bbi1234567890/RP2040-Keyboard/KiCad/keyboardnew.kicad_sch

## KiCad design KiCad/keyboardnew.kicad_sch (2026-07-10)

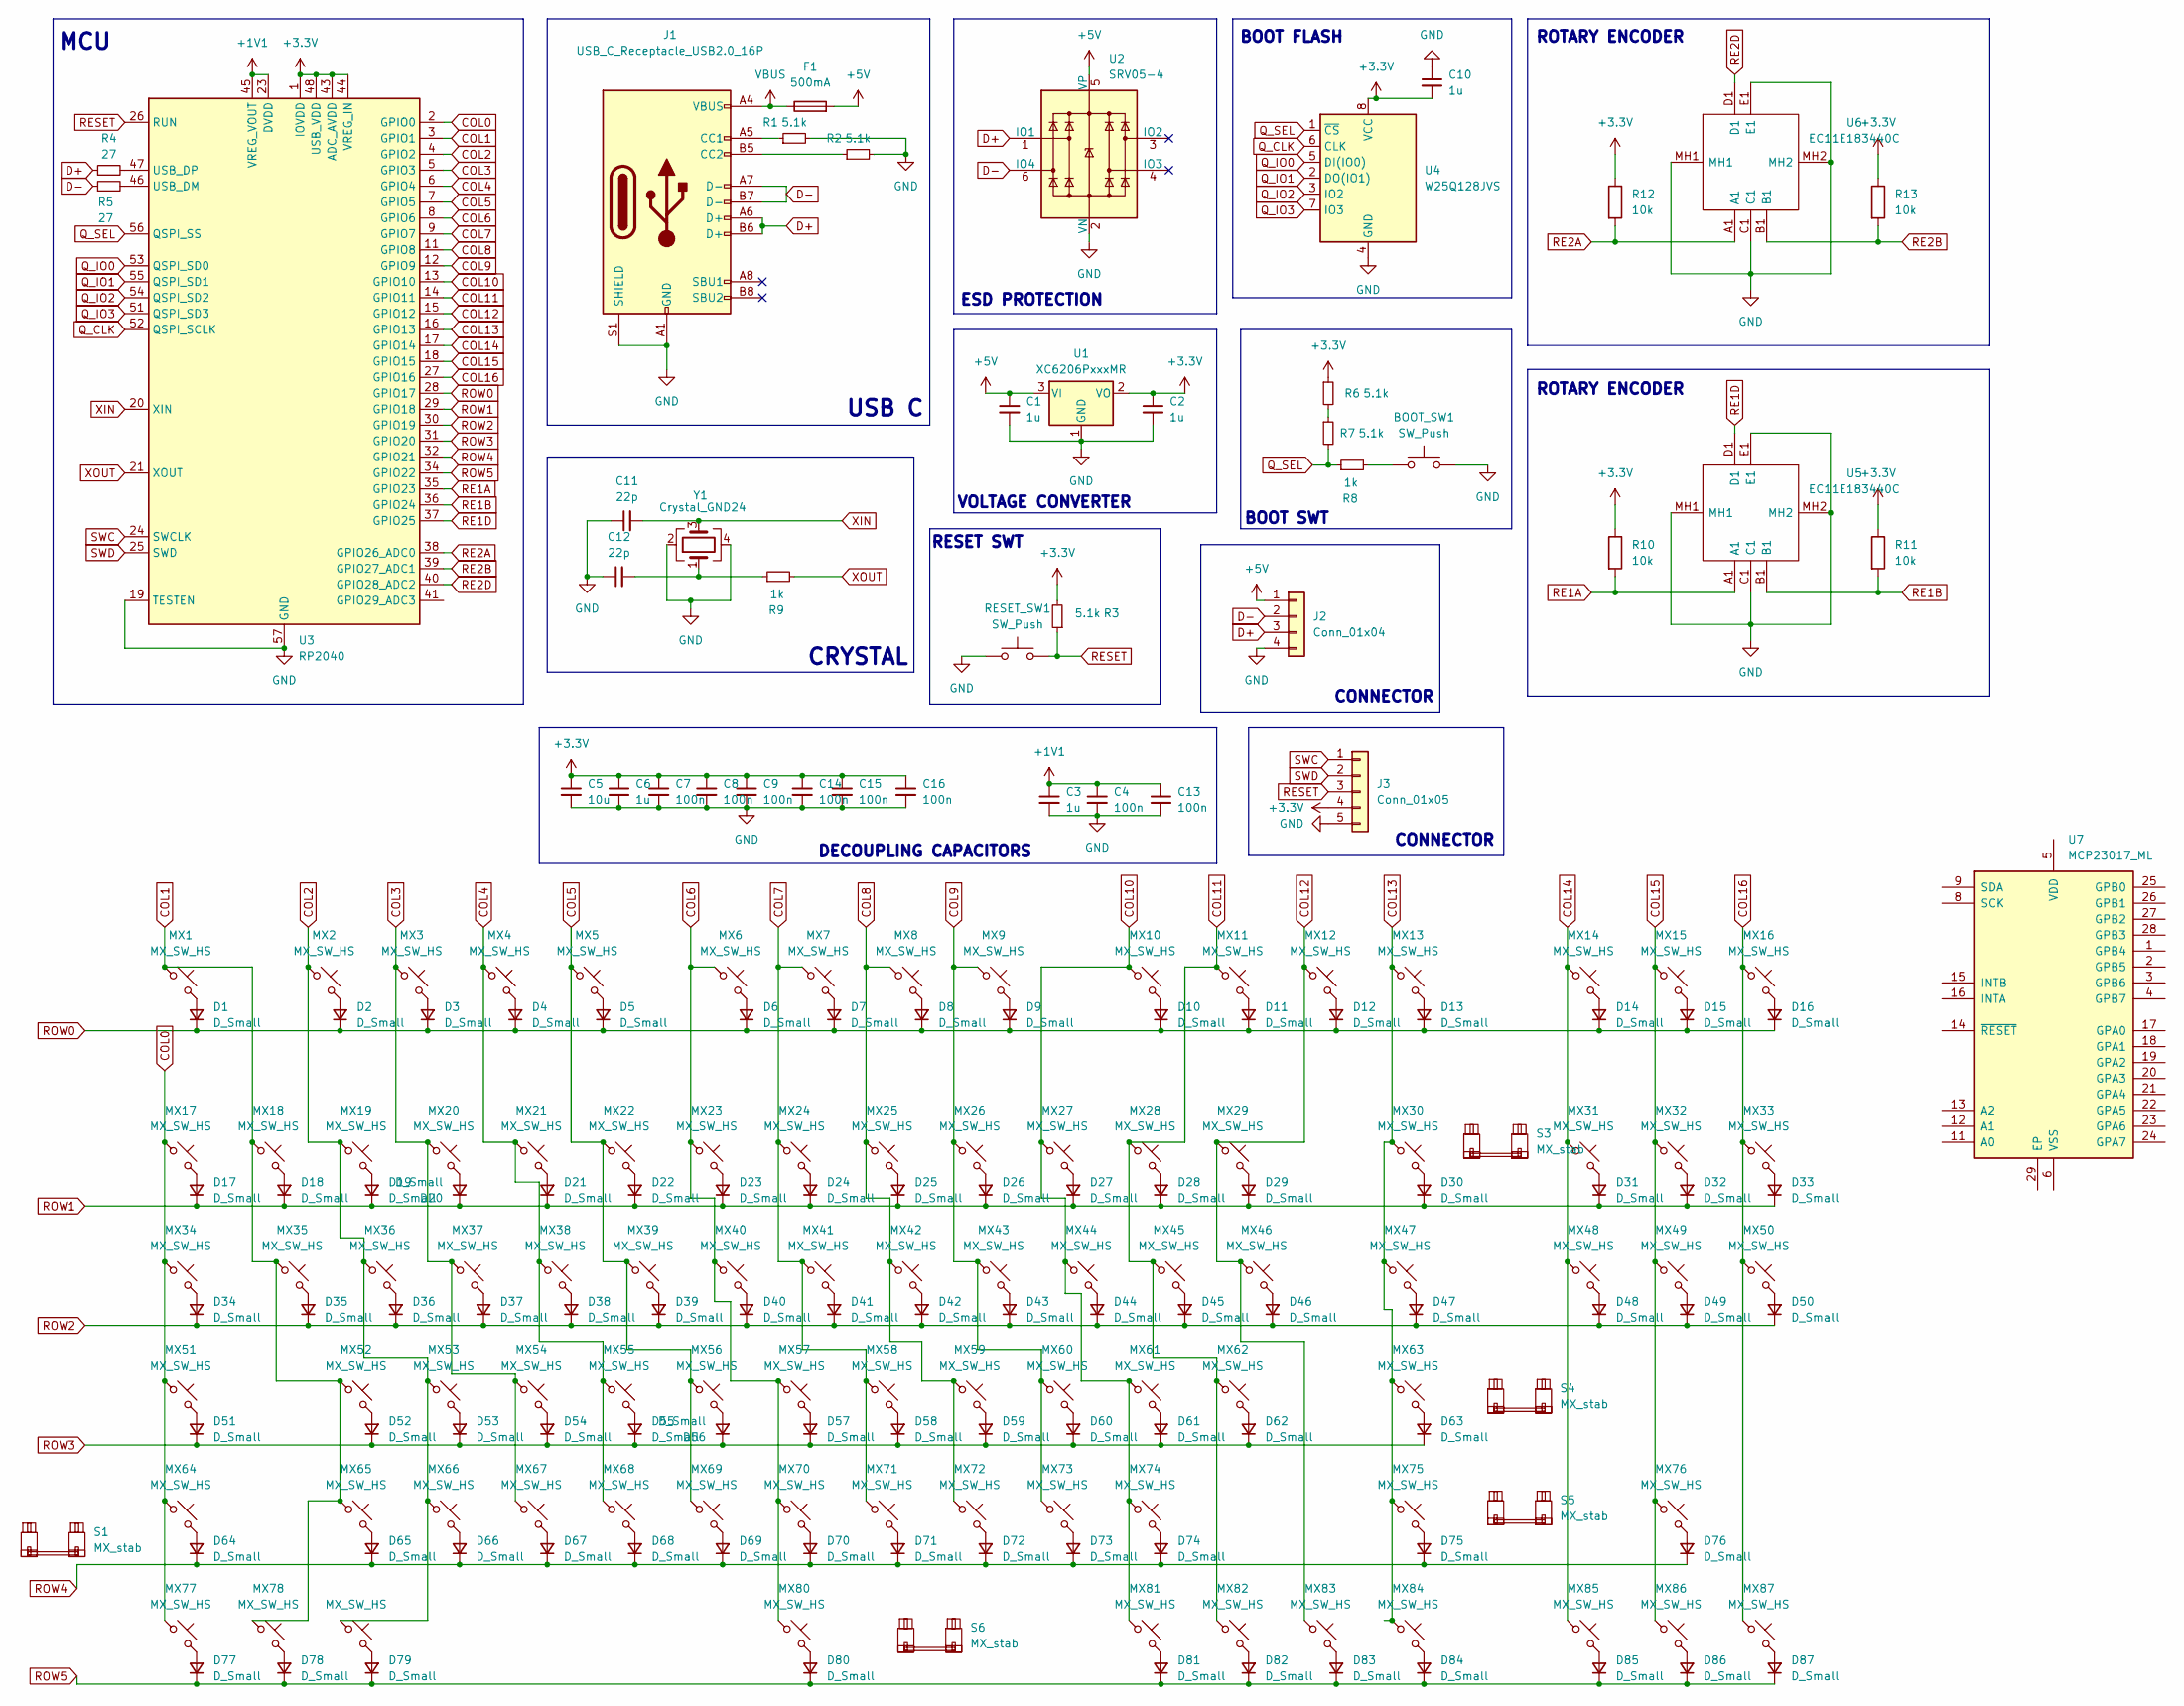
[picture p1: schematic keyboardnew.kicad_sch]

Parts:
BOOT_SW1: SW_Push; SW_SPST_TL3342; Part Number TL3342F160QG
C1, C2, C3, C6, C10: 1u; C_0402_1005Metric; Part Number TMK105BJ105MV-F
C4, C7, C8, C9, C13, C14, C15, C16: 100n; C_0402_1005Metric; Part Number LMK105BJ104KV-F
C5: 10u; C_0603_1608Metric; Part Number AMK105CBJ106MVHF
C11, C12: 22p; C_0402_1005Metric; Part Number 04023A220FAT2A
D1, D2, D3, D4, D5, D6, D7, D8, D9, D10, D11, D12, D13, D14, D15, D16, D17, D18, D19, D20, D21, D22, D23, D24, D25, D26, D27, D28, D29, D30, D31, D32, D33, D34, D35, D36, D37, D38, D39, D40, D41, D42, D43, D44, D45, D46, D47, D48, D49, D50, D51, D52, D53, D54, D55, D56, D57, D58, D59, D60, D61, D62, D63, D64, D65, D66, D67, D68, D69, D70, D71, D72, D73, D74, D75, D76, D77, D78, D79, D80, D81, D82, D83, D84, D85, D86, D87: D_Small; D_SOD-123; Part Number MMSD4148
F1: 500mA; Fuse_1206_3216Metric; Part Number SF-1206FP050-2
J1: USB_C_Receptacle_USB2.0_16P; USB_C_Receptacle_HRO_TYPE-C-31-M-12; Part Number TYPE-C-31-M-12
J2: Conn_01x04; JST_SH_SM04B-SRSS-TB_1x04-1MP_P1.00mm_Horizontal; Part Number SM04B-SRSS-TB
J3: Conn_01x05; PinHeader_1x05_P2.54mm_Vertical; Part Number PH1-05-UA
MX1, MX2, MX3, MX4, MX5, MX6, MX7, MX8, MX9, MX10, MX11, MX12, MX13, MX14, MX15, MX16, MX17, MX18, MX19, MX20, MX21, MX22, MX23, MX24, MX25, MX26, MX27, MX28, MX29, MX30, MX31, MX32, MX33, MX35, MX36, MX37, MX38, MX39, MX40, MX41, MX42, MX43, MX44, MX45, MX46, MX48, MX49, MX50, MX52, MX53, MX54, MX55, MX56, MX57, MX58, MX59, MX60, MX61, MX62, MX63, MX64, MX65, MX66, MX67, MX68, MX69, MX70, MX71, MX72, MX73, MX74, MX75, MX76, MX80, MX85, MX86, MX87: MX_SW_HS; SW_MX_HS_CPG151101S11_1u; Part Number CPG151101S11-16
MX34, MX47: MX_SW_HS; SW_MX_HS_KS-2P02B01-01_1.5u; Part Number CPG151101S11-16
MX51: MX_SW_HS; SW_MX_HS_KS-2P02B01-01_1.75u; Part Number CPG151101S11-16
MX77, MX78, MX79, MX81, MX82, MX83, MX84: MX_SW_HS; SW_MX_HS_KS-2P02B01-01_1.25u; Part Number CPG151101S11-16
R1, R2, R3, R6, R7: 5.1k; R_0402_1005Metric; Part Number ERJ-2RKF5101X
R4, R5: 27; R_0402_1005Metric; Part Number ERJ-2RKF27R0X
R8, R9: 1k; R_0402_1005Metric; Part Number ERJ-2RKF1001X
R10, R11, R12, R13: 10k; R_0402_1005Metric; Part Number ERJ-2RKF1002X
RESET_SW1: SW_Push; SW_SPST_TL3342; Part Number TL3342F160QG
S1, S4: MX_stab; STAB_MX_P_2.25u
S3: MX_stab; STAB_MX_P_2u
S5: MX_stab; STAB_MX_P_2.75u
S6: MX_stab; STAB_MX_P_6.25u
U1: XC6206PxxxMR; SOT-23-3; Part Number XC6206P502MR
U2: SRV05-4; SOT-23-6-routable; Part Number SRV05-4MR6T1G
U3: RP2040; QFN-56-1EP_7x7mm_P0.4mm_EP3.2x3.2mm; Part Number RP2040
U4: W25Q128JVS; SOIC-8_5.23x5.23mm_P1.27mm; Part Number W25Q128JVSIM
U5, U6: EC11E183440C; Manufacturer_Part_Number EC11E183440C; Mouser Part Number 688-EC11E183440C
U7: MCP23017_ML; QFN-28-1EP_6x6mm_P0.65mm_EP4.25x4.25mm
Y1: Crystal_GND24; Crystal_SMD_3225-4Pin_3.2x2.5mm; Part Number ABM8-272-T3

Connections:
+1V1: C3.1, C4.1, C13.1, U3.23 (DVDD), U3.45 (VREG_VOUT), U3.50 (DVDD)
+3.3V: C2.1, C5.1, C6.1, C7.1, C8.1, C9.1, C10.2, C14.1, C15.1, C16.1, J3.4, R3.2, R6.1, R10.1, R11.1, R12.1, R13.1, U1.2 (VO), U3.1 (IOVDD), U3.10 (IOVDD), U3.22 (IOVDD), U3.33 (IOVDD), U3.42 (IOVDD), U3.43 (ADC_AVDD), U3.44 (VREG_IN), U3.48 (USB_VDD), U3.49 (IOVDD), U4.8 (VCC)
+5V: C1.1, F1.2, J2.1, U1.3 (VI), U2.5 (VP)
COL0: MX17.1, MX34.1, MX51.1, MX64.1, MX77.1, U3.2 (GPIO0)
COL1: MX1.1, MX18.1, MX35.1, MX52.1, MX65.1, MX78.1, U3.3 (GPIO1)
COL2: MX2.1, MX19.1, MX36.1, MX53.1, MX66.1, MX79.1, U3.4 (GPIO2)
COL3: MX3.1, MX20.1, MX37.1, MX54.1, MX67.1, U3.5 (GPIO3)
COL4: MX4.1, MX21.1, MX38.1, MX55.1, MX68.1, U3.6 (GPIO4)
COL5: MX5.1, MX22.1, MX39.1, MX56.1, MX69.1, U3.7 (GPIO5)
COL6: MX6.1, MX23.1, MX40.1, MX57.1, MX70.1, MX80.1, U3.8 (GPIO6)
COL7: MX7.1, MX24.1, MX41.1, MX58.1, MX71.1, U3.9 (GPIO7)
COL8: MX8.1, MX25.1, MX42.1, MX59.1, MX72.1, U3.11 (GPIO8)
COL9: MX9.1, MX26.1, MX43.1, MX60.1, MX73.1, U3.12 (GPIO9)
COL10: MX10.1, MX27.1, MX44.1, MX61.1, MX74.1, MX81.1, U3.13 (GPIO10)
COL11: MX11.1, MX28.1, MX45.1, MX62.1, MX82.1, U3.14 (GPIO11)
COL12: MX12.1, MX29.1, MX46.1, MX83.1, U3.15 (GPIO12)
COL13: MX13.1, MX30.1, MX47.1, MX63.1, MX75.1, MX84.1, U3.16 (GPIO13)
COL14: MX14.1, MX31.1, MX48.1, MX85.1, U3.17 (GPIO14)
COL15: MX15.1, MX32.1, MX49.1, MX76.1, MX86.1, U3.18 (GPIO15)
COL16: MX16.1, MX33.1, MX50.1, MX87.1, U3.27 (GPIO16)
D+: J1.A6 (D+), J1.B6 (D+), J2.3, R4.1, U2.1 (IO1)
D-: J1.A7 (D-), J1.B7 (D-), J2.2, R5.1, U2.6 (IO4)
GND: BOOT_SW1.2, C1.2, C2.2, C3.2, C4.2, C5.2, C6.2, C7.2, C8.2, C9.2, C10.1, C11.1, C12.1, C13.2, C14.2, C15.2, C16.2, J1.A1 (GND), J1.A12 (GND), J1.B1 (GND), J1.B12 (GND), J1.S1 (SHIELD), J2.4, J3.5, R1.2, R2.2, RESET_SW1.1, U1.1 (GND), U2.2 (VN), U3.19 (TESTEN), U3.57 (GND), U4.4 (GND), U5.C1, U5.E1, U5.MH1, U5.MH2, U6.C1, U6.E1, U6.MH1, U6.MH2, Y1.2, Y1.4
unnamed: BOOT_SW1.1, R8.2
unnamed: C12.2, R9.1, Y1.1
unnamed: D1.2 (A), MX1.2
unnamed: D2.2 (A), MX2.2
unnamed: D3.2 (A), MX3.2
unnamed: D4.2 (A), MX4.2
unnamed: D5.2 (A), MX5.2
unnamed: D6.2 (A), MX6.2
unnamed: D7.2 (A), MX7.2
unnamed: D8.2 (A), MX8.2
unnamed: D9.2 (A), MX9.2
unnamed: D10.2 (A), MX10.2
unnamed: D11.2 (A), MX11.2
unnamed: D12.2 (A), MX12.2
unnamed: D13.2 (A), MX13.2
unnamed: D14.2 (A), MX14.2
unnamed: D15.2 (A), MX15.2
unnamed: D16.2 (A), MX16.2
unnamed: D17.2 (A), MX17.2
unnamed: D18.2 (A), MX18.2
unnamed: D19.2 (A), MX19.2
unnamed: D20.2 (A), MX20.2
unnamed: D21.2 (A), MX21.2
unnamed: D22.2 (A), MX22.2
unnamed: D23.2 (A), MX23.2
unnamed: D24.2 (A), MX24.2
unnamed: D25.2 (A), MX25.2
unnamed: D26.2 (A), MX26.2
unnamed: D27.2 (A), MX27.2
unnamed: D28.2 (A), MX28.2
unnamed: D29.2 (A), MX29.2
unnamed: D30.2 (A), MX30.2
unnamed: D31.2 (A), MX31.2
unnamed: D32.2 (A), MX32.2
unnamed: D33.2 (A), MX33.2
unnamed: D34.2 (A), MX34.2
unnamed: D35.2 (A), MX35.2
unnamed: D36.2 (A), MX36.2
unnamed: D37.2 (A), MX37.2
unnamed: D38.2 (A), MX38.2
unnamed: D39.2 (A), MX39.2
unnamed: D40.2 (A), MX40.2
unnamed: D41.2 (A), MX41.2
unnamed: D42.2 (A), MX42.2
unnamed: D43.2 (A), MX43.2
unnamed: D44.2 (A), MX44.2
unnamed: D45.2 (A), MX45.2
unnamed: D46.2 (A), MX46.2
unnamed: D47.2 (A), MX47.2
unnamed: D48.2 (A), MX48.2
unnamed: D49.2 (A), MX49.2
unnamed: D50.2 (A), MX50.2
unnamed: D51.2 (A), MX51.2
unnamed: D52.2 (A), MX52.2
unnamed: D53.2 (A), MX53.2
unnamed: D54.2 (A), MX54.2
unnamed: D55.2 (A), MX55.2
unnamed: D56.2 (A), MX56.2
unnamed: D57.2 (A), MX57.2
unnamed: D58.2 (A), MX58.2
unnamed: D59.2 (A), MX59.2
unnamed: D60.2 (A), MX60.2
unnamed: D61.2 (A), MX61.2
unnamed: D62.2 (A), MX62.2
unnamed: D63.2 (A), MX63.2
unnamed: D64.2 (A), MX64.2
unnamed: D65.2 (A), MX65.2
unnamed: D66.2 (A), MX66.2
unnamed: D67.2 (A), MX67.2
unnamed: D68.2 (A), MX68.2
unnamed: D69.2 (A), MX69.2
unnamed: D70.2 (A), MX70.2
unnamed: D71.2 (A), MX71.2
unnamed: D72.2 (A), MX72.2
unnamed: D73.2 (A), MX73.2
unnamed: D74.2 (A), MX74.2
unnamed: D75.2 (A), MX75.2
unnamed: D76.2 (A), MX76.2
unnamed: D77.2 (A), MX77.2
unnamed: D78.2 (A), MX78.2
unnamed: D79.2 (A), MX79.2
unnamed: D80.2 (A), MX80.2
unnamed: D81.2 (A), MX81.2
unnamed: D82.2 (A), MX82.2
unnamed: D83.2 (A), MX83.2
unnamed: D84.2 (A), MX84.2
unnamed: D85.2 (A), MX85.2
unnamed: D86.2 (A), MX86.2
unnamed: D87.2 (A), MX87.2
unnamed: J1.A5 (CC1), R1.1
unnamed: J1.B5 (CC2), R2.1
unnamed: R4.2, U3.47 (USB_DP)
unnamed: R5.2, U3.46 (USB_DM)
unnamed: R6.2, R7.1
Q_CLK: U3.52 (QSPI_SCLK), U4.6 (CLK)
Q_IO0: U3.53 (QSPI_SD0), U4.5 (DI(IO0))
Q_IO1: U3.55 (QSPI_SD1), U4.2 (DO(IO1))
Q_IO2: U3.54 (QSPI_SD2), U4.3 (IO2)
Q_IO3: U3.51 (QSPI_SD3), U4.7 (IO3)
Q_SEL: R7.2, R8.1, U3.56 (QSPI_SS), U4.1 (~CS)
RE1A: R10.2, U3.35 (GPIO23), U5.A1
RE1B: R11.2, U3.36 (GPIO24), U5.B1
RE1D: U3.37 (GPIO25), U5.D1
RE2A: R12.2, U3.38 (GPIO26_ADC0), U6.A1
RE2B: R13.2, U3.39 (GPIO27_ADC1), U6.B1
RE2D: U3.40 (GPIO28_ADC2), U6.D1
RESET: J3.3, R3.1, RESET_SW1.2, U3.26 (RUN)
ROW0: D1.1 (K), D2.1 (K), D3.1 (K), D4.1 (K), D5.1 (K), D6.1 (K), D7.1 (K), D8.1 (K), D9.1 (K), D10.1 (K), D11.1 (K), D12.1 (K), D13.1 (K), D14.1 (K), D15.1 (K), D16.1 (K), U3.28 (GPIO17)
ROW1: D17.1 (K), D18.1 (K), D19.1 (K), D20.1 (K), D21.1 (K), D22.1 (K), D23.1 (K), D24.1 (K), D25.1 (K), D26.1 (K), D27.1 (K), D28.1 (K), D29.1 (K), D30.1 (K), D31.1 (K), D32.1 (K), D33.1 (K), U3.29 (GPIO18)
ROW2: D34.1 (K), D35.1 (K), D36.1 (K), D37.1 (K), D38.1 (K), D39.1 (K), D40.1 (K), D41.1 (K), D42.1 (K), D43.1 (K), D44.1 (K), D45.1 (K), D46.1 (K), D47.1 (K), D48.1 (K), D49.1 (K), D50.1 (K), U3.30 (GPIO19)
ROW3: D51.1 (K), D52.1 (K), D53.1 (K), D54.1 (K), D55.1 (K), D56.1 (K), D57.1 (K), D58.1 (K), D59.1 (K), D60.1 (K), D61.1 (K), D62.1 (K), D63.1 (K), U3.31 (GPIO20)
ROW4: D64.1 (K), D65.1 (K), D66.1 (K), D67.1 (K), D68.1 (K), D69.1 (K), D70.1 (K), D71.1 (K), D72.1 (K), D73.1 (K), D74.1 (K), D75.1 (K), D76.1 (K), U3.32 (GPIO21)
ROW5: D77.1 (K), D78.1 (K), D79.1 (K), D80.1 (K), D81.1 (K), D82.1 (K), D83.1 (K), D84.1 (K), D85.1 (K), D86.1 (K), D87.1 (K), U3.34 (GPIO22)
SWC: J3.1, U3.24 (SWCLK)
SWD: J3.2, U3.25 (SWD)
VBUS: F1.1, J1.A4 (VBUS), J1.A9 (VBUS), J1.B4 (VBUS), J1.B9 (VBUS)
XIN: C11.2, U3.20 (XIN), Y1.3
XOUT: R9.2, U3.21 (XOUT)

Notes on the sheet:
BOOT FLASH
ROTARY ENCODER
CONNECTOR
VOLTAGE CONVERTER
MCU
ESD PROTECTION
CRYSTAL
RESET SWT
BOOT SWT
USB C
DECOUPLING CAPACITORS
